PA2ER/sis5351a-GPS-controlled-time-base/ABM8G/ABM8G-25.000MHZ-4Y-T3.step

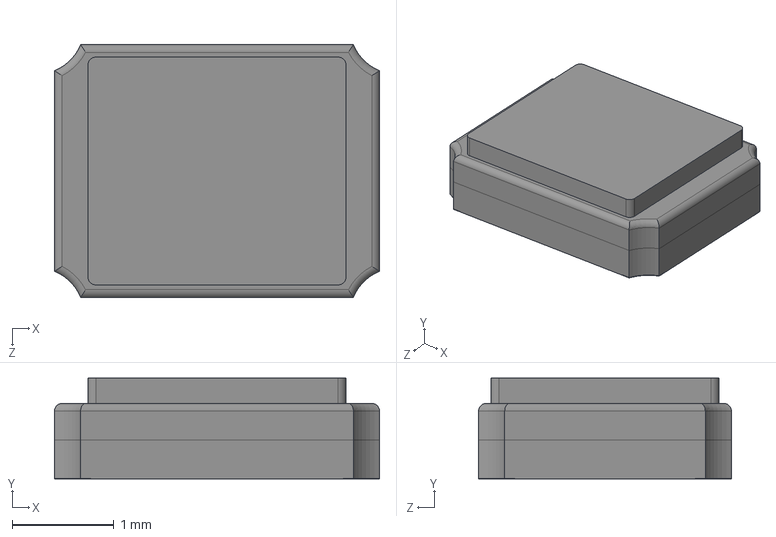
[picture p1: CAD file, 2024-07-05]
ABM8G/ABM8G-25.000MHZ-4Y-T3.step
3.20 x 0.991 x 2.49 mm
