PA2ER/sis5351a-GPS-controlled-time-base/Adafruit Si5351A.step

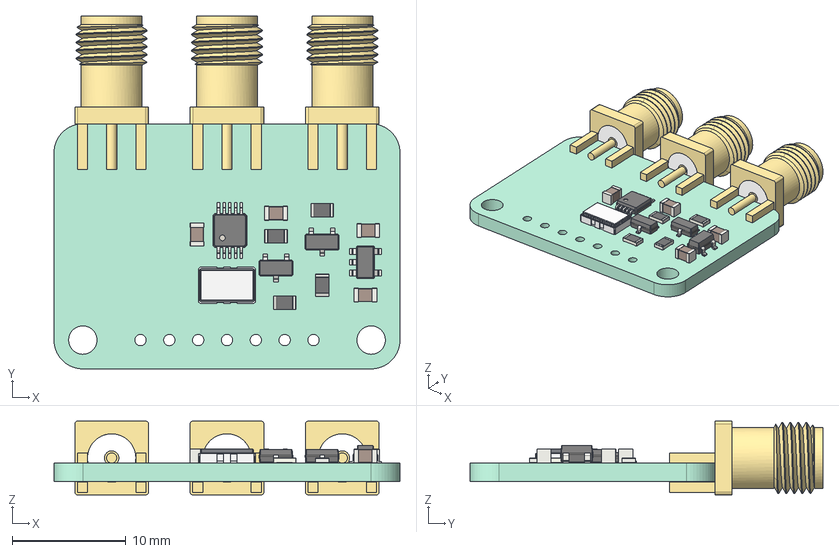
[picture p2: CAD file, 2024-07-05]
Adafruit Si5351A.step
30.5 x 31.1 x 6.50 mm
Pcb_5295
Y1_Oscillator_SMD_Fox_FT5H_5.0x3.2mm_915f5fcf52f0
R8_R_0805_2012Metric_89e25ffe3f06 x 4
Dielectric x 3
Pin x 3
U2_SOT_23_5_4691a53e2b81
Q2_SOT_23_689e5a18b5bb x 2
C3_C_0805_2012Metric_7d4d6c1dfcb6 x 4
U1_MSOP_10_3x3mm_P05mm_82a22f1be9b5
