PA2ER/sis5351a-GPS-controlled-time-base/RF2_49B_T_00_50_G_HDW/RF2-49B-T-00-50-G-HDW.step

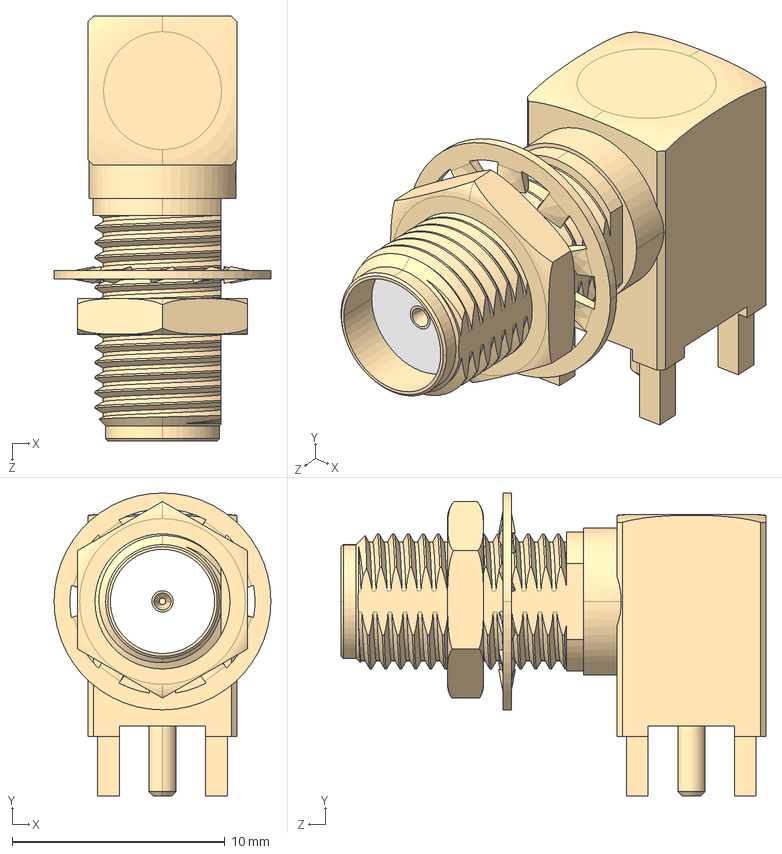
[picture p3: CAD file, 2024-07-05]
RF2_49B_T_00_50_G_HDW/RF2-49B-T-00-50-G-HDW.step
10.2 x 14.2 x 20.0 mm
