PA2ER/sis5351a-GPS-controlled-time-base/10118193_0001LF/10118193-0001LF.step

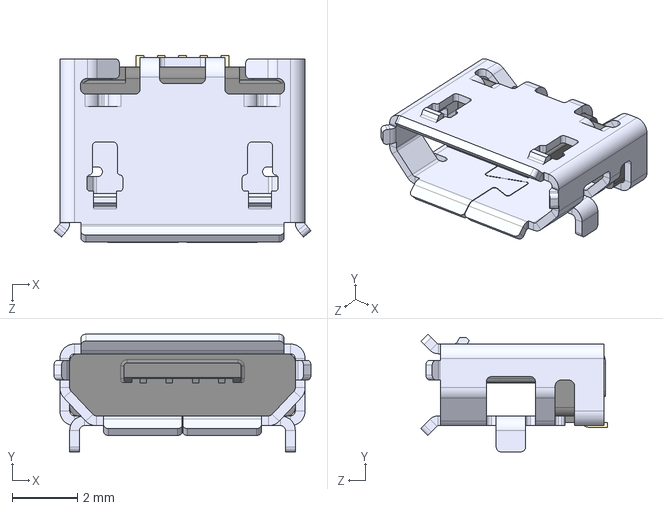
[picture p4: CAD file, 2024-07-05]
10118193_0001LF/10118193-0001LF.step
7.86 x 3.60 x 5.71 mm
