PA2ER/sis5351a-GPS-controlled-time-base/sis5351a GPS controlled time base.kicad_pcb

## KiCad design sis5351a GPS controlled time base.kicad_pcb (2024-10-13)

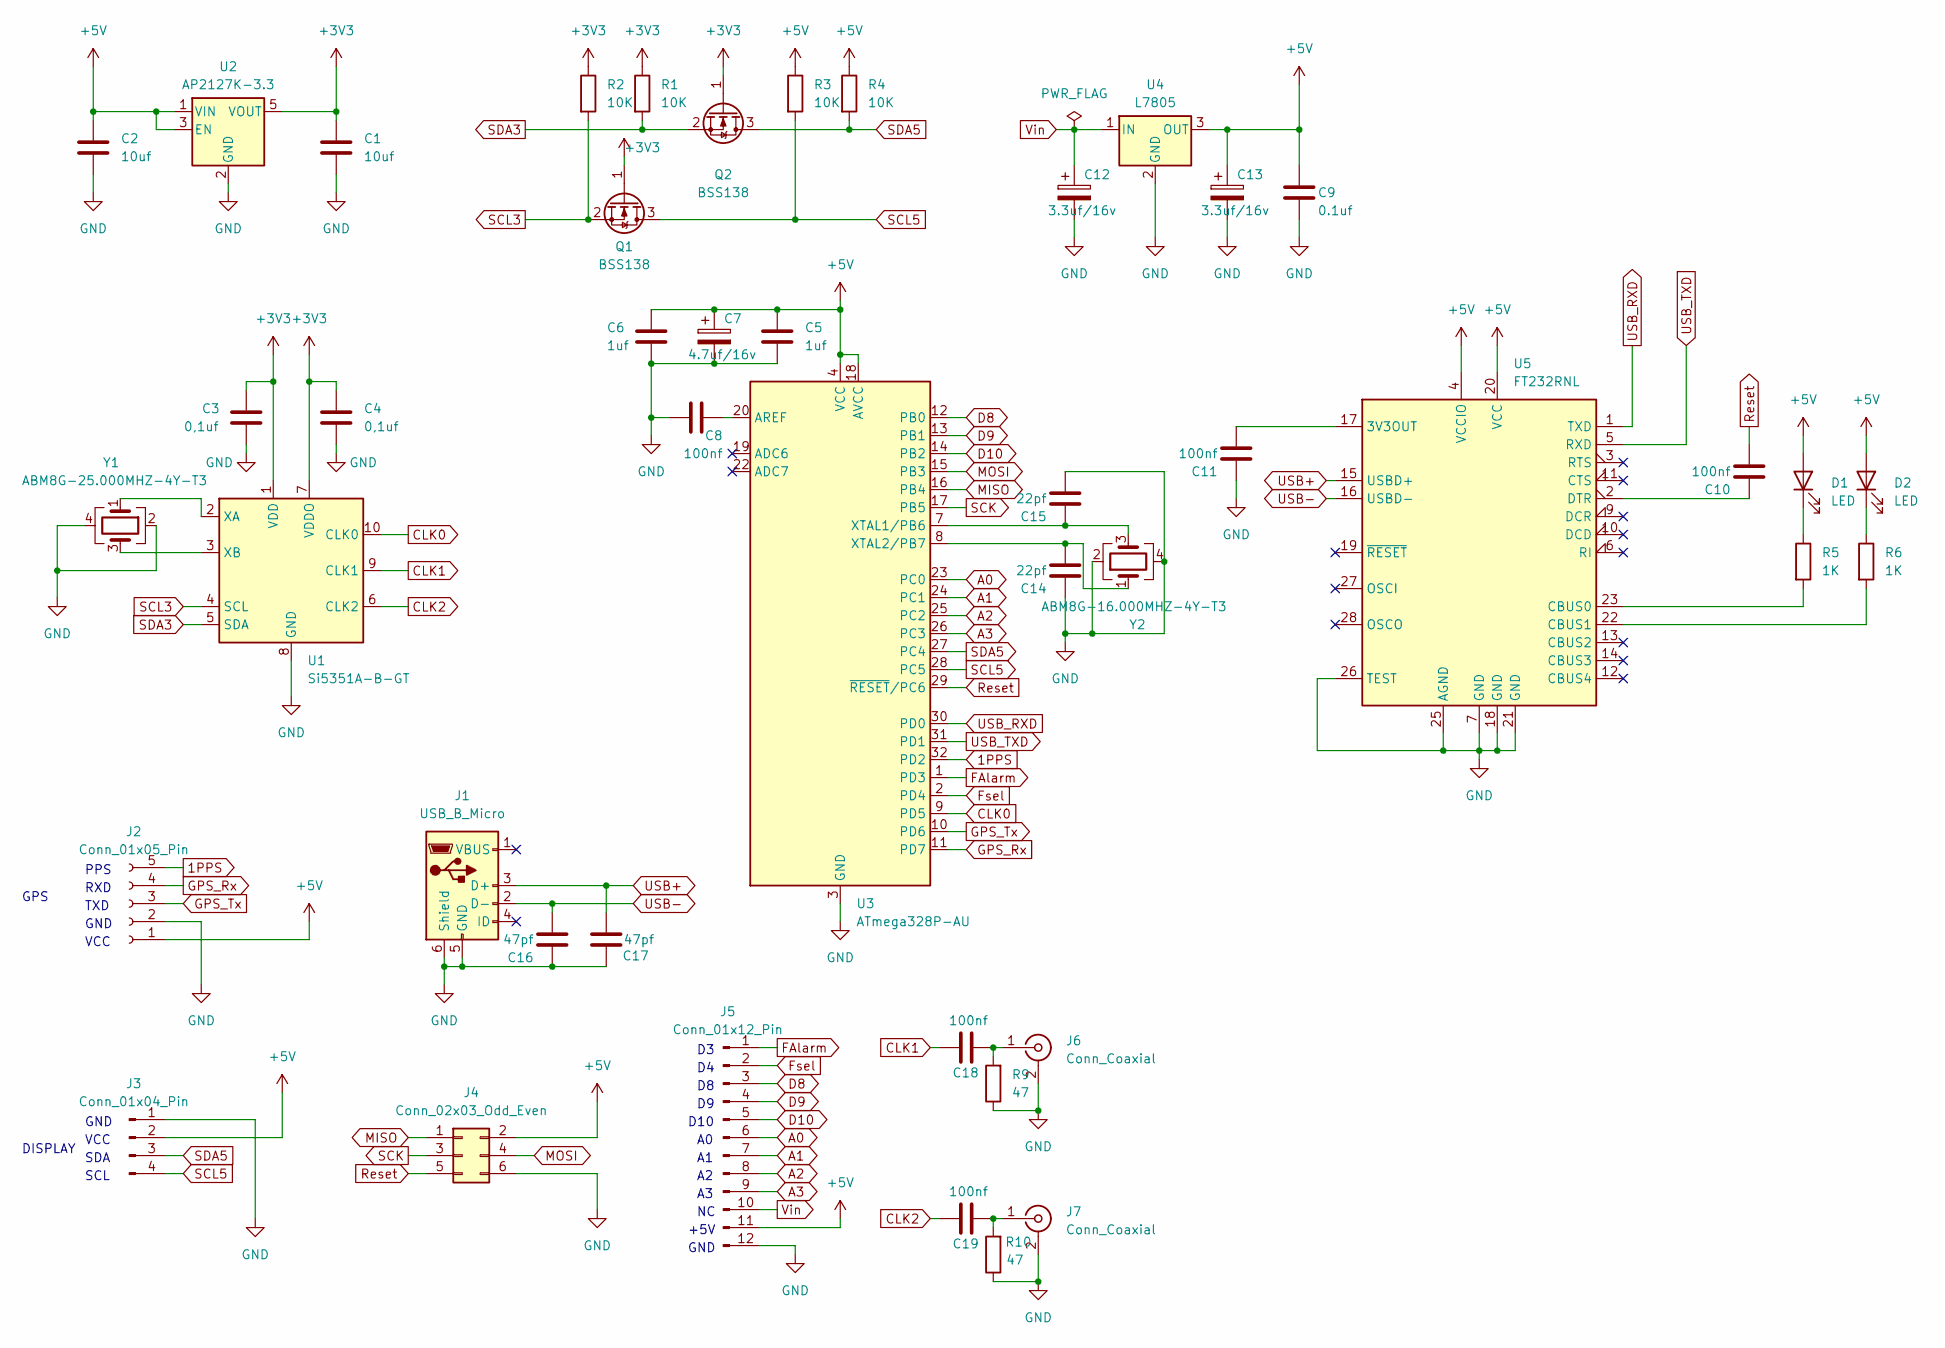
[picture p5: schematic sis5351a GPS controlled time base.kicad_sch]

Parts:
C1, C2: 10uf; C_0805_2012Metric_Pad1.18x1.45mm_HandSolder
C3, C4: 0,1uf; C_0805_2012Metric_Pad1.18x1.45mm_HandSolder
C5, C6: 1uf; C_0805_2012Metric_Pad1.18x1.45mm_HandSolder
C7: 4.7uf/16v; C_1206_3216Metric_Pad1.33x1.80mm_HandSolder
C8, C10, C11, C18, C19: 100nf; C_0805_2012Metric_Pad1.18x1.45mm_HandSolder
C9: 0.1uf; C_0805_2012Metric_Pad1.18x1.45mm_HandSolder
C12, C13: 3.3uf/16v; C_1206_3216Metric_Pad1.33x1.80mm_HandSolder
C14, C15: 22pf; C_0805_2012Metric_Pad1.18x1.45mm_HandSolder
C16, C17: 47pf; C_0805_2012Metric_Pad1.18x1.45mm_HandSolder
D1, D2: LED; LED_0805_2012Metric_Pad1.15x1.40mm_HandSolder
J1: USB_B_Micro; USB_Micro-B_Amphenol_10118193-0001LF_Horizontal
J2: Conn_01x05_Pin; PinSocket_1x05_P2.54mm_Vertical
J3: Conn_01x04_Pin; PinHeader_1x04_P2.54mm_Vertical
J4: Conn_02x03_Odd_Even; PinHeader_2x03_P2.54mm_Vertical
J5: Conn_01x12_Pin; PinHeader_1x12_P2.54mm_Vertical
J6, J7: Conn_Coaxial; SMA_Amphenol_901-143_Horizontal
Q1, Q2: BSS138; SOT-23
R1, R2, R3, R4: 10K; R_0805_2012Metric_Pad1.20x1.40mm_HandSolder
R5, R6: 1K; R_0805_2012Metric_Pad1.20x1.40mm_HandSolder
R9, R10: 47; R_0805_2012Metric_Pad1.20x1.40mm_HandSolder
U1: Si5351A-B-GT; MSOP-10_3x3mm_P0.5mm
U2: AP2127K-3.3; SOT-23-5
U3: ATmega328P-AU; TQFP-32_7x7mm_P0.8mm
U4: L7805; TO-220-3_Horizontal_TabDown
U5: FT232RNL; SSOP-28_5.3x10.2mm_P0.65mm
Y1: ABM8G-25.000MHZ-4Y-T3; Crystal_SMD_3225-4Pin_3.2x2.5mm_HandSoldering
Y2: ABM8G-16.000MHZ-4Y-T3; Crystal_SMD_3225-4Pin_3.2x2.5mm_HandSoldering

Connections:
1PPS: J2.5, U3.32 (PD2)
+3V3: C1.1, C3.1, C4.1, Q1.1 (G), Q2.1 (G), R1.1, R2.1, U1.1 (VDD), U1.7 (VDDO), U2.5 (VOUT)
+5V: C2.1, C5.1, C6.1, C7.1, C9.1, C13.1, D1.2 (A), D2.2 (A), J2.1, J3.2, J4.2, J5.11, R3.1, R4.1, U2.1 (VIN), U2.3 (EN), U3.4 (VCC), U3.6 (VCC), U3.18 (AVCC), U4.3 (OUT), U5.4 (VCCIO), U5.20 (VCC)
A0: J5.6, U3.23 (PC0)
A1: J5.7, U3.24 (PC1)
A2: J5.8, U3.25 (PC2)
A3: J5.9, U3.26 (PC3)
CLK0: U1.10 (CLK0), U3.9 (PD5)
CLK1: C18.2, U1.9 (CLK1)
CLK2: C19.2, U1.6 (CLK2)
D8: J5.3, U3.12 (PB0)
D9: J5.4, U3.13 (PB1)
D10: J5.5, U3.14 (PB2)
FAlarm: J5.1, U3.1 (PD3)
Fsel: J5.2, U3.2 (PD4)
GND: C1.2, C2.2, C3.2, C4.2, C5.2, C6.2, C7.2, C8.1, C9.2, C11.1, C12.2, C13.2, C14.1, C15.2, C16.1, C17.1, J1.5 (GND), J1.6 (Shield), J2.2, J3.1, J4.6, J5.12, J6.2 (Ext), J7.2 (Ext), R9.1, R10.1, U1.8 (GND), U2.2 (GND), U3.3 (GND), U3.5 (GND), U3.21 (GND), U4.2 (GND), U5.7 (GND), U5.18 (GND), U5.21 (GND), U5.25 (AGND), U5.26 (TEST), Y1.2, Y1.4, Y2.2, Y2.4
GPS_Rx: J2.4, U3.11 (PD7)
GPS_Tx: J2.3, U3.10 (PD6)
MISO: J4.1, U3.16 (PB4)
MOSI: J4.4, U3.15 (PB3)
unnamed: D1.1 (K), R5.1
unnamed: D2.1 (K), R6.1
unnamed: C18.1, J6.1 (In), R9.2
unnamed: C19.1, J7.1 (In), R10.2
unnamed: U1.2 (XA), Y1.1
unnamed: U1.3 (XB), Y1.3
unnamed: C8.2, U3.20 (AREF)
unnamed: C15.1, U3.7 (XTAL1/PB6), Y2.3
unnamed: C14.2, U3.8 (XTAL2/PB7), Y2.1
unnamed: C11.2, U5.17 (3V3OUT)
unnamed: R5.2, U5.23 (CBUS0)
unnamed: R6.2, U5.22 (CBUS1)
unnamed: C10.1, U5.2 (DTR)
Reset: C10.2, J4.5, U3.29 (~RESET/PC6)
SCK: J4.3, U3.17 (PB5)
SCL3: Q1.2 (S), R2.2, U1.4 (SCL)
SCL5: J3.4, Q1.3 (D), R3.2, U3.28 (PC5)
SDA3: Q2.2 (S), R1.2, U1.5 (SDA)
SDA5: J3.3, Q2.3 (D), R4.2, U3.27 (PC4)
USB+: C17.2, J1.3 (D+), U5.15 (USBD+)
USB-: C16.2, J1.2 (D-), U5.16 (USBD-)
USB_RXD: U3.30 (PD0), U5.1 (TXD)
USB_TXD: U3.31 (PD1), U5.5 (RXD)
Vin: C12.1, J5.10, U4.1 (IN)

Notes on the sheet:
GND
RXD
+5V
PPS
VCC
TXD
D10
SDA
DISPLAY
GPS
SCL

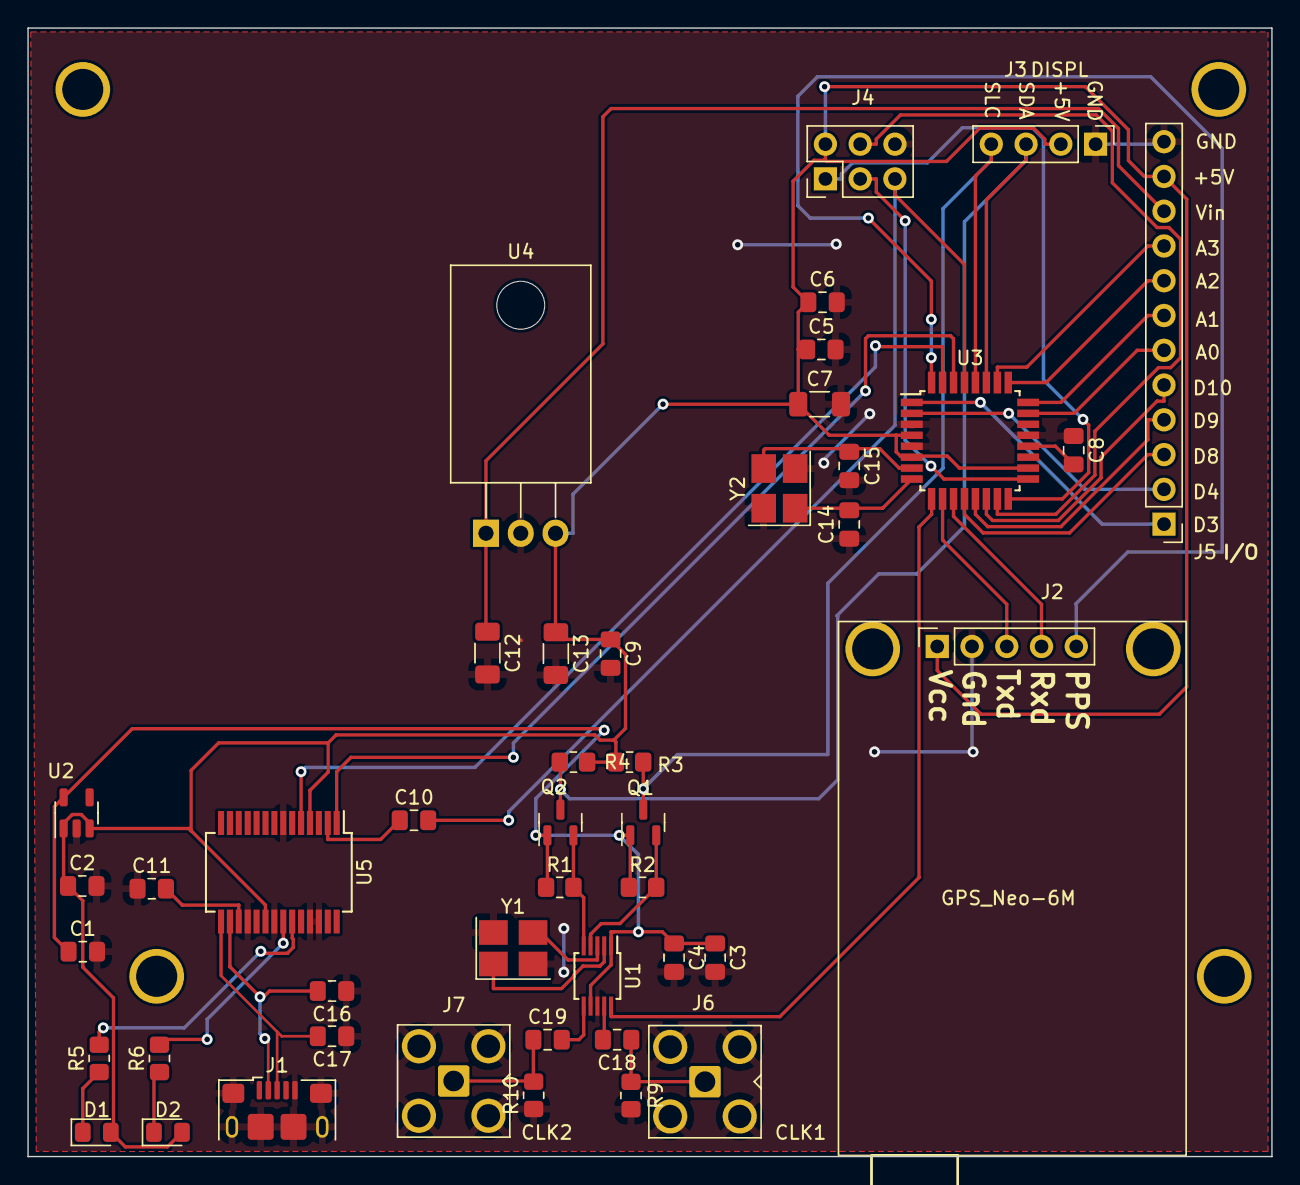
[picture p6: board sis5351a GPS controlled time base.kicad_pcb from above]

Board: 2 copper layers, 90.9 x 82.5 mm, 45 parts (0 on the bottom side), 44 nets.
