PA2ER/sis5351a-GPS-controlled-time-base/(commit log)

2024-10-13 Fault in I2C level converter
    [sis5351a GPS controlled time base.kicad_pcb, sis5351a GPS controlled time base.kicad_sch]
2024-10-13 Cleanup dir
    [sis5351a GPS controlled time base-B_Cu.gbr, sis5351a GPS controlled time base-B_Mask.gbr, sis5351a GPS controlled time base-B_Paste.gbr, sis5351a GPS controlled time base-B_Silkscreen.gbr, sis5351a GPS controlled time base-Edge_Cuts.gbr, sis5351a GPS controlled time base-F_Cu.gbr, sis5351a GPS controlled time base-F_Mask.gbr, sis5351a GPS controlled time base-F_Paste.gbr]
